theloukou/ESP32_leanometer/README.md

# ESP32 Leanometer
Motorcycle Leanometer built around ESP32 module

**WORK IN PROGRESS**
