theloukou/ESP32_leanometer/PCB/leanometer_esp32.kicad_pcb

## KiCad design PCB/leanometer_esp32.kicad_pcb (2024-06-05)

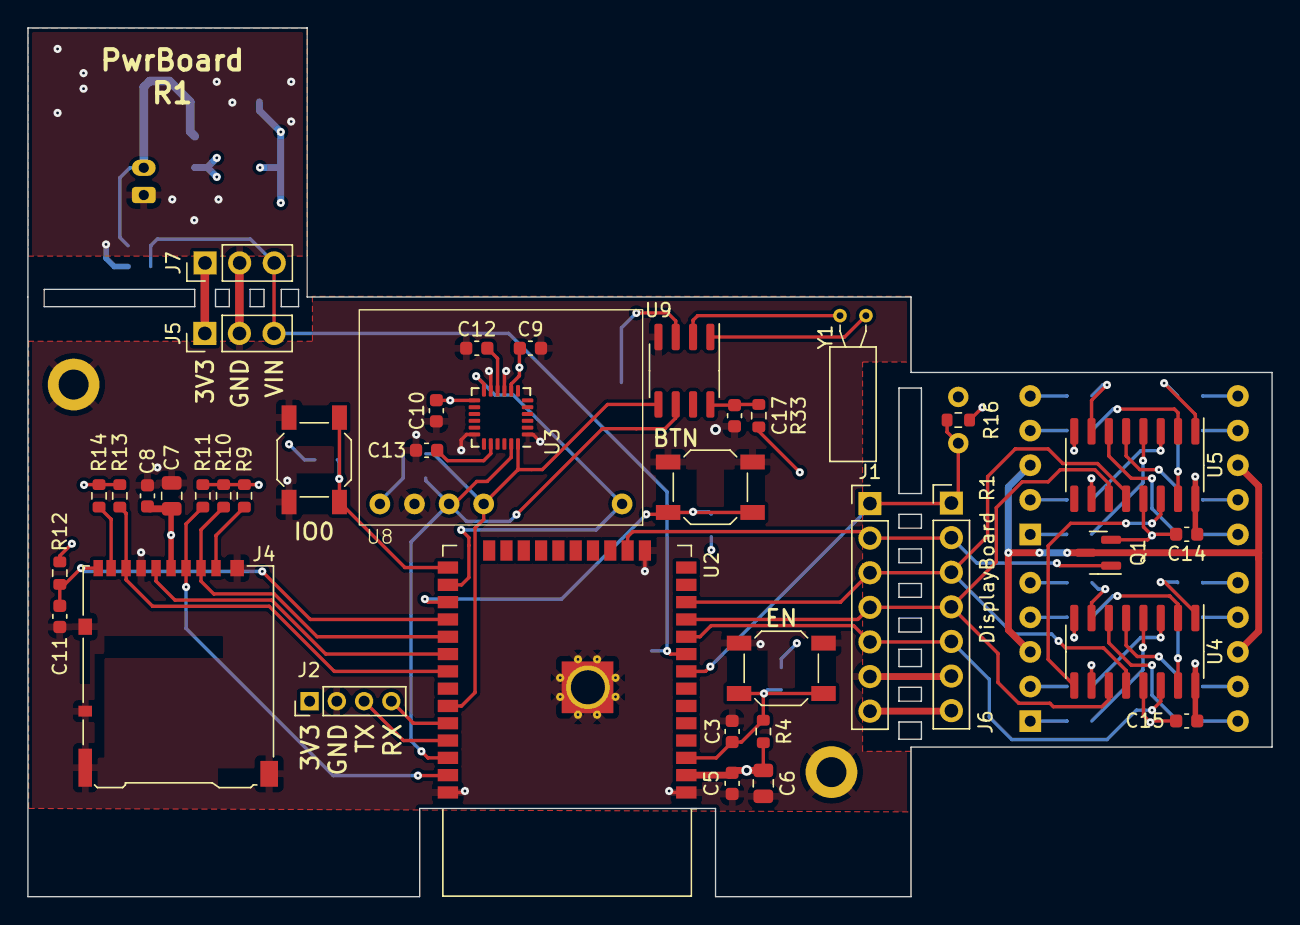
[picture p5: board leanometer_esp32.kicad_pcb from above]

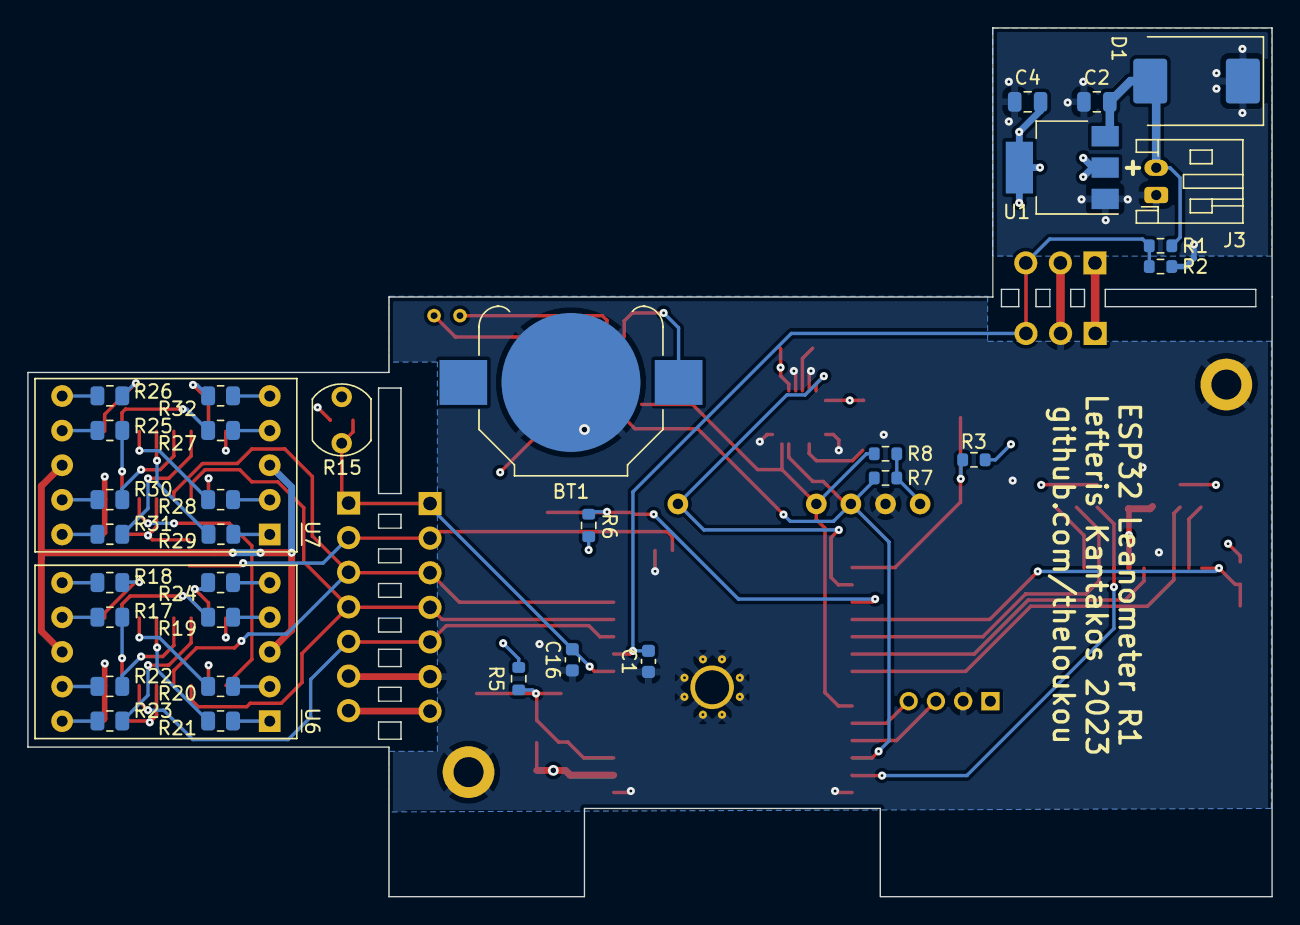
[picture p6: board leanometer_esp32.kicad_pcb from below]

Board: 4 copper layers, 91.3 x 63.8 mm, 75 parts (34 on the bottom side), 64 nets.

Parts:
BT1: Battery_Cell; BatteryHolder_Keystone_3000_1x12mm
C1, C3, C6, C8, C9, C10, C11, C12, C14, C15, C16, C17: 100nF; C_0603_1608Metric
C2, C4, C7: 10uF; C_0805_2012Metric
C5: 22uF; C_0805_2012Metric
C13: 2.2nF; C_0603_1608Metric
D1: SMCJ15A; D_SMC
H1, H2: MountingHole_Pad; MountingHole_2.2mm_M2_DIN965_Pad
J1, J6: Conn_01x07; PinHeader_1x07_P2.54mm_Vertical
J2: PROG; PinHeader_1x04_P2.00mm_Vertical
J3: VBAT; JST_PH_S2B-PH-K_1x02_P2.00mm_Horizontal
J4: DM3AT-SF-PEJM5; microSD_HC_Hirose_DM3AT-SF-PEJM5
J5, J7: Conn_01x03; PinHeader_1x03_P2.54mm_Vertical
Q1: BSS138; SOT-23
R1: 33K; R_0603_1608Metric
R2: 8.2K; R_0603_1608Metric
R3, R4, R5, R6, R7, R8, R9, R10, R11, R12, R13, R14, R16: 10K; R_0603_1608Metric
R15: LDR07; R_LDR_5.1x4.3mm_P3.4mm_Vertical
R17, R18, R19, R20, R21, R22, R23, R24, R25, R26, R27, R28, R29, R30, R31, R32: 100R; R_0805_2012Metric
R33: 1K; R_0603_1608Metric
SW1, SW2, SW3: SW_Push; SW_SPST_SKQG_WithStem
U1: LD1117S33TR_SOT223; SOT-223-3_TabPin2
U2: ESP32-WROOM-32D
U3: MPU-6050; InvenSense_QFN-24_4x4mm_P0.5mm
U4, U5: 74HC595; SOIC-16_3.9x9.9mm_P1.27mm
U6, U7: D168K; D1X8K
U8: GY-521; GY-521_NoSlave+AD0
U9: PCF8523; SOIC-8_3.9x4.9mm_P1.27mm
Y1: 32.768KHz; Crystal_C38-LF_D3.0mm_L8.0mm_Horizontal

Connections:
+3V3: C4.1, C5.2, C6.1, C7.1, C8.2, C9.1, C10.2, C14.1, C15.1, J1.7, J2.1, J4.4 (VDD), J5.1, J6.7, J7.1, R3.1, R4.1, R5.1, R6.1, R7.1, R8.1, R9.1, R10.1, R11.1, R12.1, R13.1, R14.1, R15.1, R33.1, U1.2 (VO), U2.2 (VDD), U3.8 (VLOGIC), U3.13 (VDD), U4.10 (~SRCLR), U4.16 (VCC), U5.10 (~SRCLR), U5.16 (VCC), U8.1 (VCC)
+BATT: C2.1, D1.2 (A2), J3.2, R1.1, U1.3 (VI)
/DisplayBoard/ADC_LDR: C16.2, J1.1, J6.1, R15.2, R16.1, U2.8 (IO32)
/DisplayBoard/DISP_BRIGHT: J1.2, J6.2, Q1.1 (G), U2.16 (IO13)
/DisplayBoard/DISP_CLOCK: J1.4, J6.4, U2.11 (IO26), U4.11 (SRCLK), U5.11 (SRCLK)
/DisplayBoard/DISP_DATA: J1.5, J6.5, U2.10 (IO25), U4.14 (SER)
/DisplayBoard/DISP_LATCH: J1.3, J6.3, U2.12 (IO27), U4.12 (RCLK), U5.12 (RCLK)
/DisplayBoard/LED_CATH: Q1.3 (D), U6.3 (CC), U6.8 (CC), U7.3 (CC), U7.8 (CC)
/DisplayBoard/SH_REG_OUT_1: U4.9 (QH'), U5.14 (SER)
/MainBoard/ADC_VBAT: C1.2, J5.3, J7.3, R1.2, R2.1, U2.9 (IO33)
/MainBoard/BUT: R6.2, SW3.1, U2.27 (IO16)
/MainBoard/EN: C3.1, R4.2, R5.2, SW2.1, U2.3 (EN)
/MainBoard/I2C_SCL: R7.2, U2.36 (IO22), U3.23 (SCL), U8.3 (SCL), U9.6 (SCL)
/MainBoard/I2C_SDA: R8.2, U2.33 (IO21), U3.24 (SDA), U8.4 (SDA), U9.5 (SDA)
/MainBoard/IMU_INT: U2.26 (IO4), U3.12 (INT), U8.8 (INT)
/MainBoard/IO0: R3.2, SW1.1, U2.25 (IO0)
/MainBoard/RX: J2.4, U2.34 (RXD0/IO3)
/MainBoard/SD_D1: J4.8 (DAT1), R14.2
/MainBoard/SD_D2: J4.1 (DAT2), R9.2
/MainBoard/SD_DET_B: C11.2, J4.9 (DET_B), R12.2, U2.28 (IO17)
/MainBoard/SD_MISO: J4.7 (DAT0), R13.2, U2.31 (IO19)
/MainBoard/SD_MOSI: J4.3 (CMD), R11.2, U2.37 (IO23)
/MainBoard/SD_SCK: J4.5 (CLK), U2.30 (IO18)
/MainBoard/SD_SS: J4.2 (DAT3/CD), R10.2, U2.29 (IO5)
/MainBoard/TX: J2.3, U2.35 (TXD0/IO1)
GND: BT1.2 (-), C1.1, C2.2, C3.2, C4.2, C5.1, C6.2, C7.2, C8.1, C9.2, C10.1, C11.1, C12.1, C13.1, C14.2, C15.2, C16.1, C17.1, D1.1 (A1), H1.1, H2.1, J1.6, J2.2, J3.1, J4.6 (VSS), J4.10 (DET_A), J4.11 (SHIELD), J5.2, J6.6, J7.2, Q1.2 (S), R2.2, R16.2, SW1.2, SW2.2, SW3.2, U1.1 (GND), U2.1 (GND), U2.15 (GND), U2.38 (GND), U2.39 (GND), U3.1 (CLKIN), U3.9 (AD0), U3.11 (FSYNC), U3.18 (GND), U4.8 (GND), U4.13 (~OE), U5.8 (GND), U5.13 (~OE), U8.2 (GND), U9.4 (VSS)
unnamed: BT1.1 (+), U9.3 (VBAT)
unnamed: C13.2, U3.20 (CPOUT)
unnamed: C12.2, U3.10 (REGOUT)
unnamed: R17.1, U4.15 (QA)
unnamed: R18.1, U4.1 (QB)
unnamed: R19.1, U4.2 (QC)
unnamed: R20.1, U4.3 (QD)
unnamed: R21.1, U4.4 (QE)
unnamed: R22.1, U4.5 (QF)
unnamed: R23.1, U4.6 (QG)
unnamed: R24.1, U4.7 (QH)
unnamed: R25.1, U5.15 (QA)
unnamed: R26.1, U5.1 (QB)
unnamed: R27.1, U5.2 (QC)
unnamed: R28.1, U5.3 (QD)
unnamed: R29.1, U5.4 (QE)
unnamed: R30.1, U5.5 (QF)
unnamed: R31.1, U5.6 (QG)
unnamed: R32.1, U5.7 (QH)
unnamed: R17.2, U6.7 (A)
unnamed: R18.2, U6.6 (B)
unnamed: R19.2, U6.4 (C)
unnamed: R20.2, U6.2 (D)
unnamed: R24.2, U6.5 (DP)
unnamed: R21.2, U6.1 (E)
unnamed: R22.2, U6.9 (F)
unnamed: R23.2, U6.10 (G)
unnamed: R25.2, U7.7 (A)
unnamed: R26.2, U7.6 (B)
unnamed: R27.2, U7.4 (C)
unnamed: R28.2, U7.2 (D)
unnamed: R32.2, U7.5 (DP)
unnamed: R29.2, U7.1 (E)
unnamed: R30.2, U7.9 (F)
unnamed: R31.2, U7.10 (G)
unnamed: U9.1 (OSCI), Y1.2
unnamed: U9.2 (OSCO), Y1.1
unnamed: C17.2, R33.2, U9.8 (VDD)
