theloukou/ESP32_leanometer/(threads)

Thread 1 (2023-05-03):

SD card detection

theloukou, 2023-05-03:
Check if SD is present on boot, if so, initialize it.
During runtime, it card detection triggers, check if card is removed/inserted, and act appropriately (flush data + de-init / init)

theloukou, 2023-07-10:
Closing issue, all dev work is done on main now

theloukou, 2023-07-13:
Init and de-init added in 4e422631feb9674ca79faf9b52ea473e94cb1eb6

Closed 2024-06-21.

Thread 2 (2023-05-03):

User button workflow

theloukou, 2023-05-03:
Button must be able to trigger sensor calibration, and change between display modes (lean angle/g-force/vBat)

theloukou, 2024-06-21:
Sensor calibration workflow done

Display modes functionality is paused for the time beeing

Closed 2024-06-21.

Thread 7 (2023-10-04):

IMU data

theloukou, 2023-10-04:
IMU must provide data for lean angle and g-forces.

theloukou, 2024-06-21:
Duplicate of issue #3

Closed 2024-06-21.

Thread 10 (2024-06-21):

Diplay auto brightness not available everywhere

theloukou, 2024-06-21:
Currently during initial voltage display, brightness is fixed (low level for outdoor viewing)
Make display auto brightness adjustment available at all times.

Closed 2024-06-21.
