theloukou/ESP32_leanometer/(commit log)

2023-04-15 1st push of code and PCB files
    [leanometer_esp32.kicad_pcb, leanometer_esp32.kicad_sch]
2023-04-15 Added MPU6050 group
    [leanometer_esp32.kicad_sch]
2023-04-16 Switched schematic to hierarchical layout, rough component placement on layout
    [DisplayBoard.kicad_sch, MainBoard.kicad_sch, leanometer_esp32.kicad_pcb, leanometer_esp32.kicad_sch]
2023-04-17 Added PowerBoard hierarchical sheet, completed layout
    [DisplayBoard.kicad_sch, MainBoard.kicad_sch, PowerBoard.kicad_sch, leanometer_esp32.kicad_pcb, leanometer_esp32.kicad_sch]
2023-04-17 Full layout rework
    [MainBoard.kicad_sch, leanometer_esp32.kicad_pcb]
2023-04-18 Added decoupling cap on ADC_LDR signal
    [MainBoard.kicad_sch, PowerBoard.kicad_sch]
2023-04-18 Finalized PCB layout Added various texts Added BOM
    [BOM.xlsx, leanometer_esp32.kicad_pcb]
2023-04-20 Removed a million breakaway vias for proper cutouts Cleaned up track stubs
    [leanometer_esp32.kicad_pcb]
2023-04-28 Restructured PCB folder
    [BOM.xlsx, DisplayBoard.kicad_sch, MainBoard.kicad_sch, PowerBoard.kicad_sch, leanometer_esp32.kicad_pcb, leanometer_esp32.kicad_sch]
2023-04-28 Added RTC circuit
    [MainBoard.kicad_sch, PowerBoard.kicad_sch, leanometer_esp32.kicad_pcb]
2023-04-28 Finalized RTC layout changes
    [MainBoard.kicad_sch, PowerBoard.kicad_sch, leanometer_esp32.kicad_pcb]
2023-04-28 Minor adjustments on PCB
    [DisplayBoard.kicad_sch, MainBoard.kicad_sch, PowerBoard.kicad_sch, leanometer_esp32.kicad_pcb, leanometer_esp32.kicad_sch]
2023-04-28 Added fabrication outputs, pdfs
    [BOM.xlsx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]
2023-04-28 Fixed mismatched via sizes
    [leanometer_esp32-B_Cu.gbr, leanometer_esp32-B_Mask.gbr, leanometer_esp32-B_Paste.gbr, leanometer_esp32-B_Silkscreen.gbr, leanometer_esp32-Edge_Cuts.gbr, leanometer_esp32-F_Cu.gbr, leanometer_esp32-F_Mask.gbr, leanometer_esp32-F_Paste.gbr]
2023-05-02 Removed unused EEPROM and MAX button code
2023-07-10 Fixed button-related naming to better reflect hardware
    [Definitions.h, buttonStuff.ino, esp32_leanometer.ino]
2023-07-13 Fixes for more reliable SD card removal
    [esp32_leanometer.ino, serverStuff.ino]
2023-07-17 Logging moves forward... Made g-force calculations available at all times for logging values Fixed SD card de-init Preliminary log file initializer
    [Definitions.h, esp32_leanometer.ino, mpuStuff.ino]
2023-07-18 Mostly logging progress Added simple incrementing naming for log filenames Added a few basic UART commands Added IMU interrupt based data reading Fixed interrupt variables into volatile
    [Definitions.h, eepromStuff.ino, esp32_leanometer.ino, mpuStuff.ino, sdStuff.ino]
2023-07-18 Switched MPU6050 to high address to accommodate the RTC IC...
2023-07-19 Initial support for DS1307 RTC ic. Will most likely be replaced for PCF8523
    [esp32_leanometer.ino, rtcStuff.ino, sdStuff.ino, serialStuff.ino]
2023-07-20 Switched rtc to PCF8523, added initial server code
2023-07-31 Added missing 3D models
    [leanometer_esp32.kicad_pcb]
2024-06-05 Various additions Added stuff for display flip (WIP) Added setup for webpage handlers Initial index webpage
    [Definitions.h, displayStuff.ino, esp32_leanometer.ino, mpuStuff.ino, serverStuff.ino]
2024-06-06 html changes. Calls setRTC function on page loading. stRTC function gets the saved date on mcu and displays it before the buttons. All requests now use fetch instead of XLM. syncRTC function now is a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
2024-06-06 Changed unit time tag to unixTime. Also added the calibration function.
2024-06-06 Added calibration server handler Added date field again on HTML Removed calibration JS function (breaks C compile?)
2024-06-07 HTML page now lives in PROGMEM instead of SPIFFS IMU cal trigger from webpage Fixed RETARDED JS error, fixed timestamp decoding
    [Definitions.h, buttonStuff.ino, esp32_leanometer.ino, mpuStuff.ino, serverStuff.ino]
2024-06-20 Refactored display update procces Added battery voltage display on boot
2024-06-21 Added display brightness adjustment on startup Fixes #10
    [displayStuff.ino, esp32_leanometer.ino]
2024-06-21 Added reset reason logging to SD if present Minor changes in SD handling to accomodate reset reason logging
    [Definitions.h, mpuStuff.ino, sdStuff.ino]
2024-06-24 Server/WIFI now turn off after 30sec with no client. Switched OTA to newer library version
